CHPTMT/zero_day/hardware/cad/README.md

Put CAD source files here (one subfolder per assembly) and export STEP/STL files alongside them.
