CHPTMT/zero_day/hardware/electrical/README.md

Put wiring diagrams, schematics and the pin map here. Keep the pin map in step with firmware/include/arm_config.h.
