CHPTMT/zero_day/report/Group31_Robotic_Arm_Report.docx

MECN3066A Mechatronics II

Project Report: Recycled Robotic Arm

Group 31

Group members and student numbers: [to be completed by the group]

Demonstration: Monday 26 October 2026, NWE Laboratory

Submitted: [date]

# 1. Summary

This report describes a three degree of freedom robotic arm built mainly from recycled foam board and plywood, driven by four SG90 micro servos and controlled by an Arduino Uno. The arm works inside the 400 mm half circle set by the brief and completes four tasks without intervention: it checks Points A and B for an object with an ultrasonic sensor and answers with one of three gestures, reads the colour at Point C and lights a matching LED, measures the loudness of a tap at Point D and points at a matching height on a volume indicator, and presses a three letter word in Morse code on a push button at Point E, which a second Uno decodes and displays.

Joint angles are calculated on the board from the station coordinates with two link inverse kinematics that account for where each sensor sits on the sensor head. A finite element analysis of both links shows peak stresses below 0.1 MPa under twice the static load, so the links are not the limiting part. A torque check shows the opposite for the actuators: holding the arm at Point B needs 86% of the stall torque of the two shoulder servos, and the worst reachable pose needs 95%. The tension spring on the main arm and the gear mesh at the base are therefore the parts of the design that decide whether the arm works reliably.

# 2. Brief and requirements

The brief defines a working area of a 400 mm half circle, 400 mm high, with stations given in cylindrical coordinates (angle from the arm's left, radius from the base axis, height above the table). Table 1 lists them.

Table 1: Stations from the project brief

Station | Angle (deg) | Radius (mm) | Height (mm) | Task
A | 10 | 350 | 320 | Object present? (ultrasonic)
B | 10 | 350 | 150 | Object present? (ultrasonic)
C | 55 | 200 | 70 | Colour of the target, shown on an LED
D | 100 | 275 | 250 | Loudness of a tap
Volume indicator | 110 | 275 | 250 | Point at a height that matches the loudness
E | 170 | 250 | 300 | Press a word in Morse code on a push button

Other requirements from the brief and the demonstration notice:

- The button at Point E sits on a breadboard that the tutor mounts on the stand; its orientation is the group's choice.
- The Morse receiver runs on a second Uno, separate from the arm controller, and shows the word on an LCD.
- Each attempt at the demonstration is filmed, and the arm controller code, the receiver code and the videos are uploaded straight after the slot.
- The arm runs from reset with no help during an attempt. The best of the attempts in the 10 minute slot counts.

# 3. Mechanical design

## 3.1 Layout

The arm has a turntable base and two links in one vertical plane. The base servo turns a hub on a 20 mm plywood platform through a gear on the hub's rim. Two side plates on the hub carry the shoulder pivot 130 mm above the table, where two SG90 servos face each other and drive the main arm together in opposite directions, which doubles the shoulder torque. The second arm servo sits at the top of the main arm. A tension spring runs from the base to the main arm and carries part of the arm's weight. The sensor head at the end of the second arm holds the ultrasonic sensor on the arm axis, the sound sensor 42 mm further out and 45 mm to one side, the colour sensor 83 mm out and 45 mm to the other side, and a 70 mm button pusher hanging below the arm end.

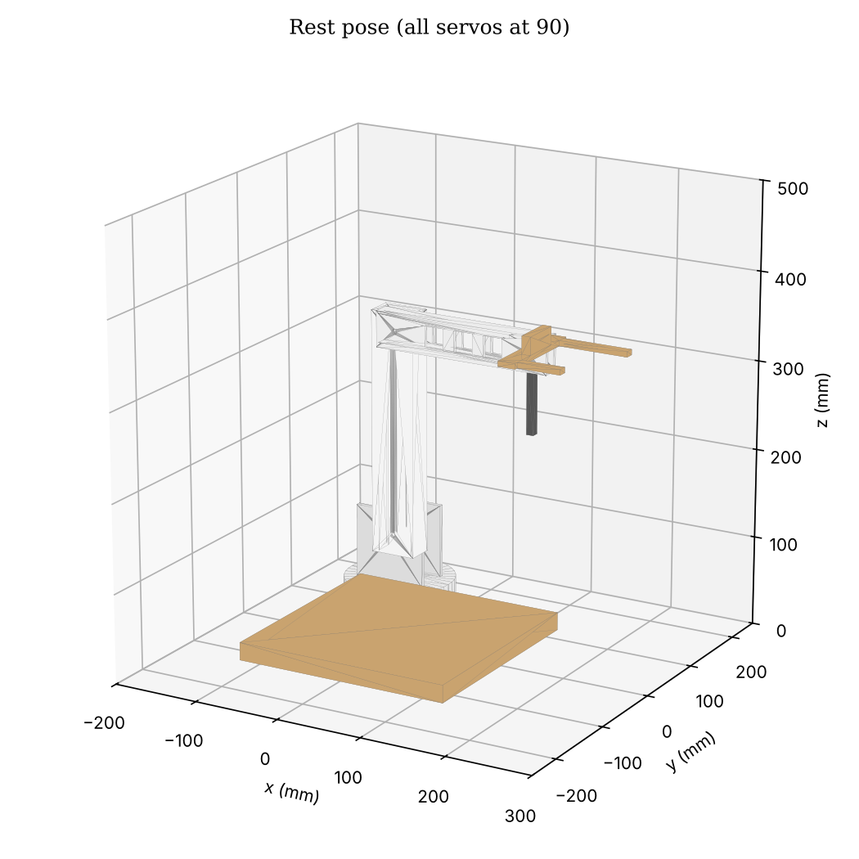
[picture p1: figure]

Figure 1: CAD model at the rest position: base facing forward, main arm upright, second arm level (all servos at 90 degrees)

Table 2: Main parts. Link masses come from the CAD volume and an assumed board density of 500 kg/m3

Part | Material | Size (mm) | Mass (g)
Base platform | Plywood | 250 x 250 x 20 | about 700
Turntable hub | Recycled tube, foam board | 120 diameter, 60 high | about 60
Main arm | 5 mm foam board box | 225 pivot to pivot, 50 x 30 section | 94
Second arm | 4 mm foam board box with three windows | 160 to the sensor head, 40 x 20 section | 36
Sensor head | Plywood, sensors, pusher, wiring | 110 wide | 46 (estimate)
Servos | SG90, 9 g, 1.8 kgf cm stall at 4.8 V | 23 x 12.2 x 22.7 | 4 x 9

## 3.2 Materials

The links are boxes made from white 5 mm foam board taped at the edges, with windows cut in the second arm to save weight. The platform and the sensor head are offcut plywood. The material properties used in the analysis are those of expanded PVC foam board (elastic modulus 800 MPa, Poisson's ratio 0.35, density 500 kg/m3, tensile strength 15 MPa), because the exact grade of the recycled board is not known. Section 6 shows that the stresses are so low that this uncertainty does not change any conclusion.

## 3.3 CAD files

The model is parametric (CadQuery, file hardware/cad/arm/build_cad.py) and uses the same dimensions as the controller code. It exports a STEP file for every part and two assemblies, one at the rest position and one at Point B. Figure 2 shows two of the working poses.

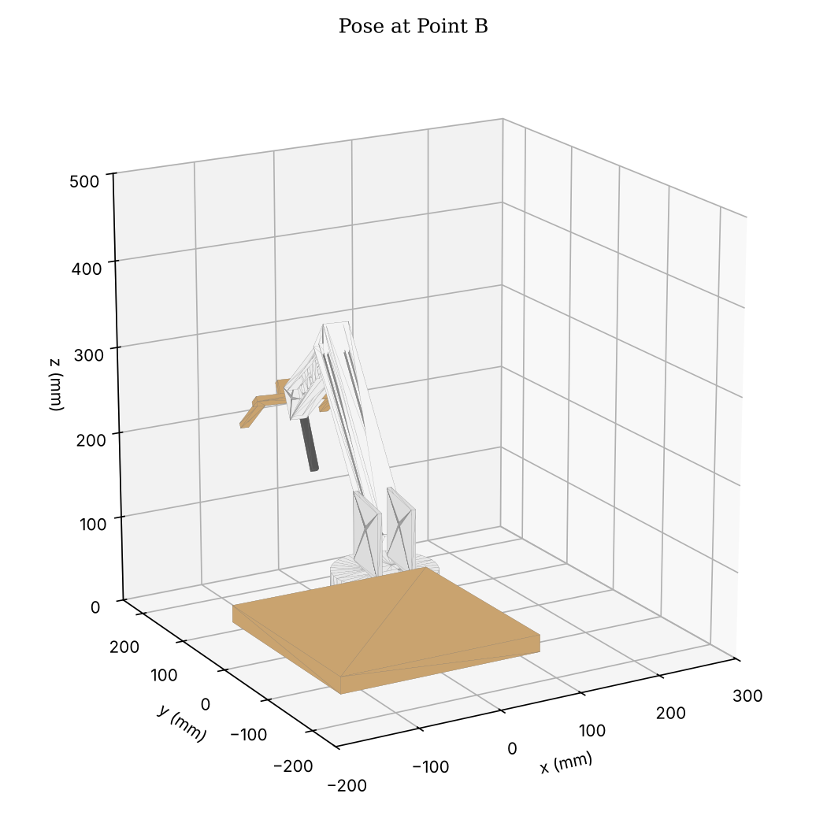
[picture p2: figure]

Figure 2: CAD model at Point B: base 80 degrees left, main arm 46.6 degrees forward, second arm 11 degrees up

# 4. Kinematics

All joint angles are relative to the rest position. The base angle is 90 degrees minus the station angle, corrected for the sideways offset of the sensor in use. In the arm's vertical plane the main arm is link 1 (225 mm, angle phi from vertical) and the second arm plus the sensor's offset along it is link 2 (160 mm plus the offset). For a target at in-plane distance r and height z, the sensor must sit a set standoff s back from the target along the direction it points. That point is solved with the law of cosines (elbow up), and because the pointing direction depends on the answer, the solution is repeated six times, which converges well within 0.1 mm.

For the button press the target is the pusher tip itself, with no standoff, so the arm can drive the tip along any line. Each press moves the tip straight down from 70 mm above the button to 20 mm into it, a 90 mm stroke. Pushing past contact means the servos keep pressing hard for the whole hold time. With two joints and a fixed button the joint angles at the press follow from the geometry, and a vertical press is mostly second arm motion. At the bottom of each press the main arm therefore leans a further 3 degrees, so the two main arm servos also push on the button.

Table 3: Joint angles calculated by the controller for each point (relative to the rest position)

Point | Sensor | Standoff (mm) | Base (deg) | Main arm (deg) | Second arm (deg)
A | Ultrasonic | 100 | 80.0 left | 23.7 forward | 20.4 up
B | Ultrasonic | 70 | 80.0 left | 46.6 forward | 11.0 up
C | Colour | 15 | 22.0 left | 33.3 forward | 40.6 down
D | Sound | 40 | 0.6 right | 13.0 forward | 11.2 down
Indicator, 150 mm | Ultrasonic | 60 | 20.0 right | 34.9 forward | 13.3 down
Indicator, 350 mm | Ultrasonic | 60 | 20.0 right | 14.2 forward | 14.6 up
E, above the button | Pusher tip | 36 above | 80.0 right | 17.2 forward | 43.8 up
E, pressing | Pusher tip | 12 in | 80.0 right | 19.4 forward | 31.5 up

Point C on the stands is a vertical blue face 70 mm above the table. With these link lengths and a shoulder 130 mm high the arm cannot bring the colour sensor down level with it: at C the second arm always points about 75 degrees down, so the sensor looks steeply down at the face from a few millimetres away. The code supports a colour sensor tilted up on a wedge (COLOUR_PITCH_DEG); with a 60 to 70 degree wedge the sensor looks at the face almost level while the arm pose hardly changes.

# 5. Actuator torque

The holding torque at each joint was calculated from the link masses in Table 2 with the second arm at its working angle. Table 4 compares it with the stall torque of the SG90 (1.8 kgf cm at 4.8 V, two servos at the shoulder).

Table 4: Static holding torque without the spring, against servo stall torque

Pose | Shoulder (kgf cm) | Share of 2 x SG90 | Elbow (kgf cm) | Share of 1 x SG90
A | 2.28 | 63% | 1.03 | 57%
B | 3.10 | 86% | 0.84 | 46%
C | 2.00 | 55% | 0.29 | 16%
D | 1.64 | 45% | 0.94 | 52%
E, above the button | 1.84 | 51% | 0.92 | 51%
Worst reachable: main arm 50 deg, second arm level | 3.41 | 95% | 1.03 | 57%

Micro servos lose accuracy and heat up well before stall, so the shoulder relies on the tension spring. Without it, Point B and any pose with the main arm leaning far forward would sag or stall. The elbow servo runs at half its stall torque just holding the head, which leaves little in reserve for pressing: a typical 6 mm tactile switch needs 1.6 to 2.5 N, and the elbow alone can add about 1 N at the 184 mm pusher lever. The straight-line press therefore uses the shoulder and elbow together, drives 20 mm past contact and leans the main arm 3 degrees extra at the bottom, so both joints push at close to full torque during the hold.

The base servo carries the turning load through a gear on the rim of the hub. When the arm leans out, the reaction lifts the hub on one side and the gear can ride out of the groove, after which every point is off by the angle lost. The controller now starts each servo gently (Section 7.3), but the lasting fix is mechanical: a washer or lip that keeps the gear in the groove, a stiffer servo mount, and if possible a thrust bearing under the hub so the base servo carries none of the arm's weight.

# 6. Structural analysis (FEA)

## 6.1 Method

Each link was meshed with 8-node hexahedral elements on a regular 2 to 2.5 mm grid that follows its real section: a hollow box with 5 mm walls for the main arm, and a 4 mm walled box with the three side windows for the second arm. Each link is clamped over the region gripped by the servo horn. Loads are the link's own weight, the weight of everything it carries and, for the second arm, the button-press reaction. A dynamic factor of 2 is applied to all weights to cover the accelerations of fast moves and the start-up jerk. The solver is written in Python (hardware/fea/fea_links.py) and solves the sparse stiffness system directly.

Before use, the solver was checked on a solid 20 x 20 x 200 mm cantilever with a 1 N tip load. The tip deflection was 0.2467 mm against 0.2520 mm from beam theory with shear (-2.1%). A pure end moment on the main arm section and a tip load on the same section each gave bending stresses within 6% of M c / I at mid span, which also confirmed the sign of the elbow moment.

## 6.2 Load cases and results

Table 5: FEA results (peak stress outside the clamp and load patches)

Case | Elements | Peak von Mises (MPa) | Safety factor on 15 MPa | Tip deflection (mm)
Second arm level, weights x2 (head 46 g at the tip) | 9072 | 0.082 | 184.0 | 0.05
Second arm pressing, weight x1 with a 0.96 N press reaction | 9072 | 0.023 | 659.0 | 0.016
Main arm at 50 deg, elbow force 1.791 N and moment 201.4 N mm, weights x2 | 12096 | 0.075 | 198.9 | 0.088

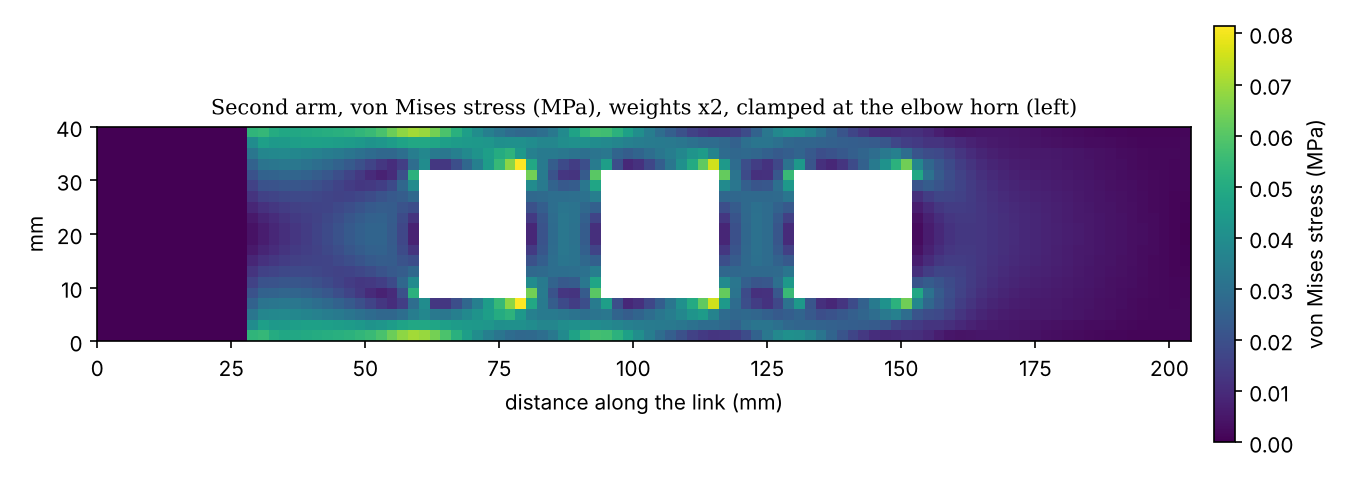
[picture p3: figure]

Figure 3: Second arm: von Mises stress with all weights doubled. The highest stresses sit at the corners of the windows

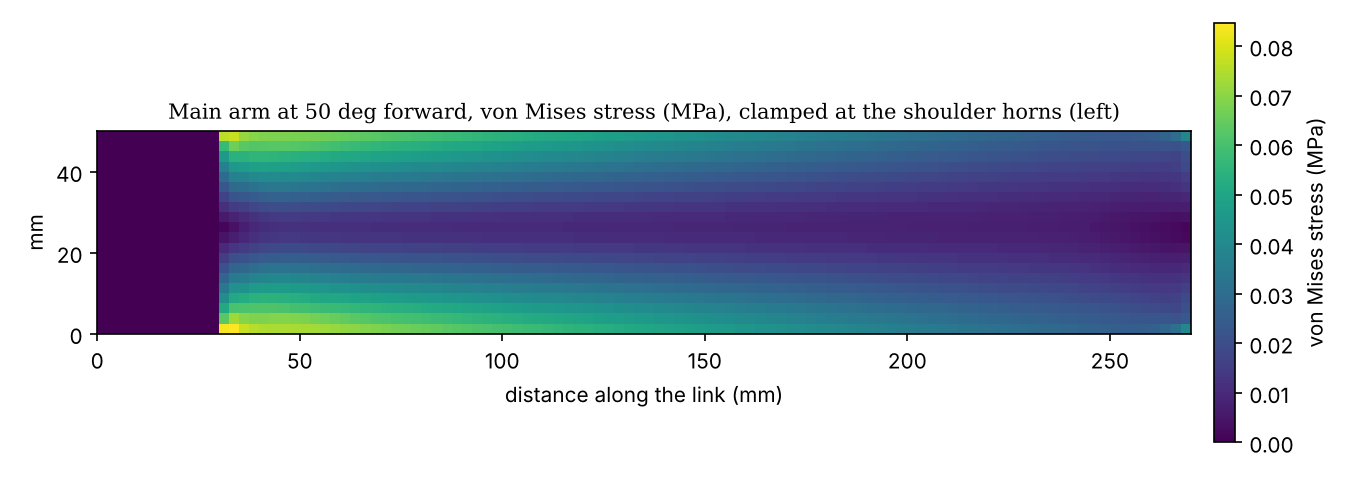
[picture p4: figure]

Figure 4: Main arm at its 50 degree limit: von Mises stress, highest in the outer walls next to the shoulder horn

## 6.3 Discussion

Peak stresses are below 0.1 MPa, at least 150 times below the strength of the board, and tip deflections are below 0.1 mm. Hand calculation agrees: the main arm moment at the shoulder in the worst pose is about 670 N mm, giving 0.08 MPa in the outer wall against 0.075 MPa from the FEA. The window corners in the second arm raise the local stress by about 50% over the plain section, which is still negligible. The links could be made lighter, and the useful saving is mass rather than strength, since every gram at the head costs elbow and shoulder torque (Section 5). The FEA does not cover the taped joints, the servo horn screws or the gear mesh, which are the parts most likely to fail in practice.

# 7. Electronics and software

## 7.1 Electronics

Table 6: Arm controller pin map

Device | Pin | Notes
Base servo | D2 | SG90
Main arm servos, left and right | D3, D4 | Driven in opposite directions
Second arm servo | D5 | SG90
Ultrasonic HC-SR04 | Echo D6, Trig D7 | 5 V
Sound sensor | A1 | Analogue output
Colour sensor TCS34725 | SDA A4, SCL A5 | Hardware I2C
Red, green, blue LEDs | D8, D9, D10 | 220 ohm each, active high
Beeper | D11 | Passive, 2.5 kHz tone
LCD monitor 16 x 2, I2C backpack | SDA A2, SCL A3 | Software I2C, address 0x27 or 0x3F
Servo supply | External 5 V, 2 A | Common ground with the Uno
Morse receiver (second Uno) | Button D7, LCD on A4/A5 | Separate board

The servos run from an external 5 V supply because four SG90s can draw more than an amp together when they start or stall, far more than the Uno's regulator can give. The LCD monitor uses A2 and A3 because the colour sensor already occupies the hardware I2C pins; a small software I2C driver in the sketch talks to it, so no library is needed.

## 7.2 Program structure

The arm controller is a state machine: rest hold, Task 1, Task 2, Task 3, Task 4, finish, idle. During the 5 s rest hold the Morse word can be typed in the Serial Monitor; it is saved in EEPROM. Each task beeps its number at the start and at the end and then waits 2 s. Every move uses cosine easing with a top joint speed of 30 degrees per second, which keeps the motion smooth and avoids jerks. The Serial Monitor prints every move in plain words, and the LCD shows the task, the distances at A and B, each result and a summary at the end.

- Task 1: the arm goes to A and measures the distance (median of five pings, at least three echoes). If nothing is straight ahead it looks a little left, right, up and down. An object counts between 2 and 25 cm. It then lifts and turns away so the visit to B is clearly separate. Object at A: YES (the sensor moves straight up and down). Object at B: NO (the base turns left and right). Nothing at either: BOX (the sensor traces a square).
- Task 2: at C the colour sensor waves over five spots, the LEDs follow what it sees, and the clearest reading decides the colour. The matching LED stays lit to the end of the run.
- Task 3: at D the arm waits up to 3 s for a tap and measures its peak to peak amplitude. It then moves to the bottom of the indicator scale and rises slowly to a height from 150 mm (quiet) to 350 mm (loud), drops back and rises again like a level meter, and holds.
- Task 4: at E each press drives the pusher straight down and up at 120 degrees per second. Dots are 600 ms and dashes 1800 ms, with 600 ms between presses and 1800 ms between letters.

## 7.3 Start-up and calibration

A hobby servo cannot report its position, so the first pulse after power-up sends it to the commanded angle at full speed. On this arm that jerk pulled cables loose and lifted the base gear out of its groove. The controller now sends each servo short bursts of pulses with pauses between them, so it creeps to the rest position: second arm first, then the main arm pair together, then the base, slowest of all. The base then sweeps slowly to both ends and back to the middle with the head lifted, which beds the gear in and shows the swing is clear. Throughout the run the base is limited to 18 degrees per second, below the 30 degrees per second of the other joints. Two calibration sketches support the set-up. test_servos lets each joint be nudged to the true rest position (the two main arm servos can be trimmed separately so they do not fight) and prints the zero values to paste into the code. capture_points takes the arm to every station as the demonstration does, lets each one be nudged onto the real stand, tunes the press depth and height at E, and prints the corrected station lines.

## 7.4 Morse timing

The receiver splits dots from dashes at 1250 ms and ends a letter after 1200 ms of silence. A release shorter than 100 ms is treated as contact bounce within the same press. The press timing was checked in an offline model of the arm that runs the real sketch, tracks the pusher tip from the servo commands and records when the button would close. With the button from 50 mm higher to 32 mm lower than its nominal position, the button saw dots of 400 to 800 ms, dashes of 1600 to 2000 ms, gaps of 390 to 790 ms inside a letter and 1590 to 1990 ms between letters, so every band is at least 350 ms from a threshold. Both receiver sketches were then run against these recorded contact timelines: 1,536 runs covering eight words, eight button heights and contact chatter up to 90 ms, and 840 runs with every edge shifted randomly by up to 150 ms, all decoded correctly.

# 8. Testing and results

## 8.1 Tests before the demonstration

- Every sketch is compiled for the Uno on each change by an automated build (GitHub Actions).
- A browser simulator runs the same joint maths and task sequence and draws the arm to scale (simulation/arm_bench.html). It was used to check reach, joint limits and the order of moves.
- An offline model compiles the real sketch on a PC with simulated sensors, servos, LCD and button, and checks the beep pattern, gestures, joint limits, LCD text and Morse decoding for different conditions.
- On the real arm, test_servos, test_sensors and test_combined were used to set the zero positions, directions, colour references and sound levels, and to visit every station.

## 8.2 Problems found and fixes

Table 7: Problems found during testing

Problem on the real arm | Cause | Fix
Main arm leaned back when it should lean forward | Servo direction | MAIN_DIR set to -1
Points off after start-up | Zero positions not set, base gear jumping teeth | Zero calibration in test_servos; soft start; gear retention
Base gear lifts out of the turntable groove | Start-up jerk and the arm's moment on the hub | Soft start, base held to 18 deg/s, slow start-up sweep; mechanical retention recommended
Button presses too weak | Elbow servo near half its stall torque just holding the head | Straight-line press with both joints, 20 mm past contact, 3 degree extra main arm lean, 120 deg/s
Visit to B not visible | A and B share one bearing | Lift and turn away between A and B
Point C is a vertical face | Arm cannot reach low enough to look level | Sensor waves over five spots; optional tilted sensor mount
Button on a sloping stand | Stand design | Breadboard mounted so the button faces up; straight-down press

## 8.3 Demonstration results

[To be completed after the demonstration: for each attempt, the conditions set by the tutors (object at A, B or neither; colour; tap; word), what the arm did at each point, and whether each task passed. Link the videos.]

Table 8: Demonstration results (to be filled in)

Attempt | Task 1 (A/B, gesture) | Task 2 (colour) | Task 3 (sound) | Task 4 (Morse)
1
2
3

# 9. Recommendations

- Hold the base gear in mesh with a lip or washer and carry the arm's weight on a thrust bearing, so the base servo only turns the hub.
- Replace the shoulder SG90 pair with metal gear servos such as the MG90S (2.2 kgf cm) or a single MG996R, or keep the spring and check its preload so the shoulder runs well below stall at Point B.
- Lighten the sensor head: every 10 g there costs about 0.16 kgf cm at the elbow.
- Mount the colour sensor on a 60 to 70 degree wedge so it faces the vertical target at C squarely.
- Use a low-force button (below 1.5 N) at Point E, or add a short spring-loaded tip to the pusher so presses are consistent.

# 10. Conclusion

The arm reaches every station in the brief with the right sensor at a set distance, using joint angles calculated on the board. The foam board links are far stronger than they need to be, while the servos, the spring and the base gear set the limits of the design. The changes made during testing (soft start, calibrated zero positions, a firm straight-line press, a wider search at A and B, a colour scan at C and a clear level-meter motion at D) target the failures seen on the real arm.

# References

1. MECN3066A Mechatronics II Project Brief 2026, University of the Witwatersrand.
2. TowerPro SG90 micro servo datasheet.
3. ams AG, TCS3472 colour light-to-digital converter datasheet.
4. Elecfreaks, HC-SR04 ultrasonic ranging module user guide.
5. Hitachi, HD44780U dot matrix LCD controller datasheet; NXP, PCF8574 remote 8-bit I/O expander datasheet.
6. Arduino, Servo library reference, https://www.arduino.cc/reference/en/libraries/servo/.
7. R. C. Hibbeler, Mechanics of Materials, Pearson.

# Appendix A: Files

Table 9: Files submitted with this report

File | Contents
arduino/arm_controller/arm_controller.ino | Demonstration program
arduino/morse_receiver, morse_receiver_i2c | Receiver on the second Uno
arduino/tests/test_servos | Zero positions, directions, sweep, manual control
arduino/tests/test_sensors | Sensor readings and calibration
arduino/tests/test_combined | Every station and movement without decisions
arduino/tests/capture_points | Station trims and press tuning on the real stands
hardware/cad/arm/*.step | CAD parts and assemblies
hardware/fea/fea_links.py, fea_results.json | FEA solver, load cases and results
simulation/arm_bench.html | Browser simulator
docs/demo_day.md, docs/wiring.md | Demonstration procedure and wiring
