CHPTMT/zero_day/arduino/morse_receiver_i2c/src/README.txt

Bundled library, so the sketch compiles without installing anything:
- LiquidCrystal_I2C 1.1.4 (github.com/johnrickman/LiquidCrystal_I2C, the Frank de Brabander library), unchanged.
