CHPTMT/zero_day/report/cad_point_E.png

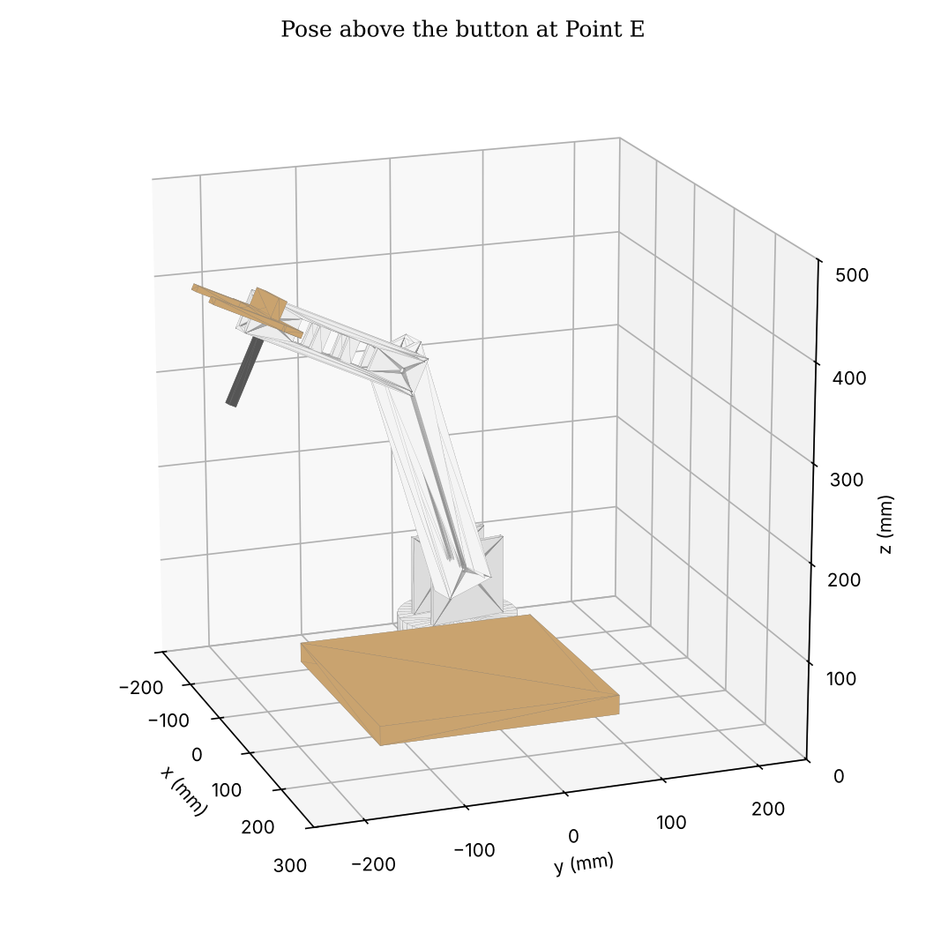
report/cad_point_E.png
