CHPTMT/zero_day/hardware/cad/arm/assembly_rest_pose.step

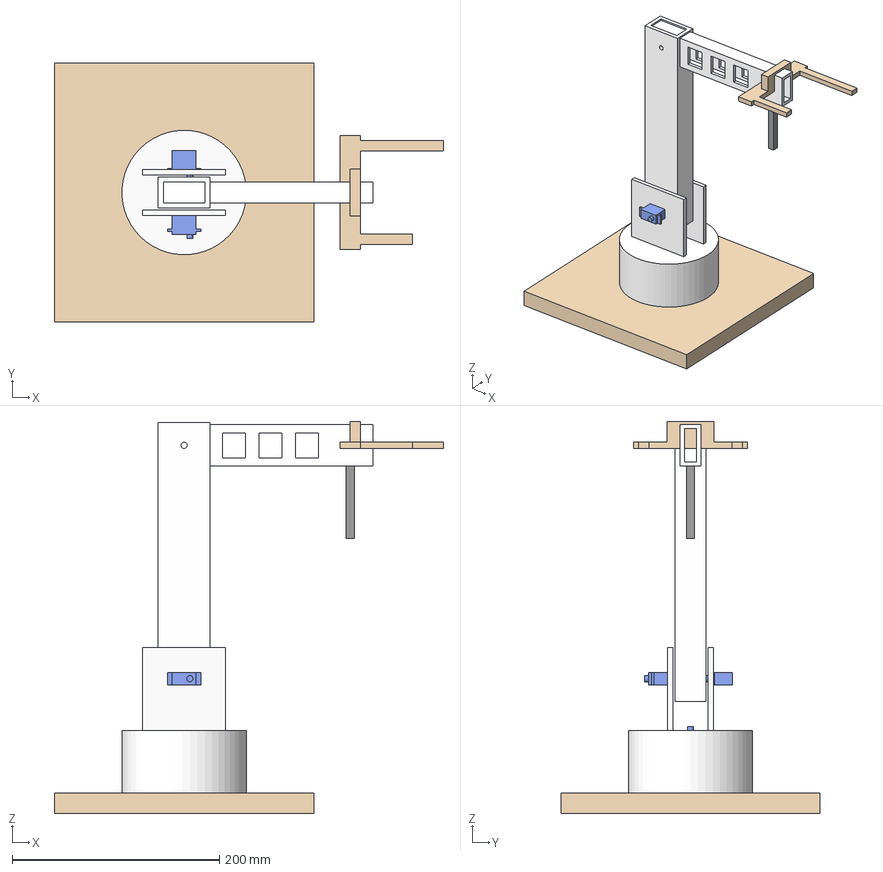
[picture p6: CAD file, 2026-10-26]
hardware/cad/arm/assembly_rest_pose.step
375.0 x 250.0 x 378.0 mm
base_plate
hub
bracket
servo_base
servo_main_left
servo_main_right
main_arm
second_arm
sensor_head
pusher
