CHPTMT/zero_day/hardware/cad/arm/assembly_point_B.step

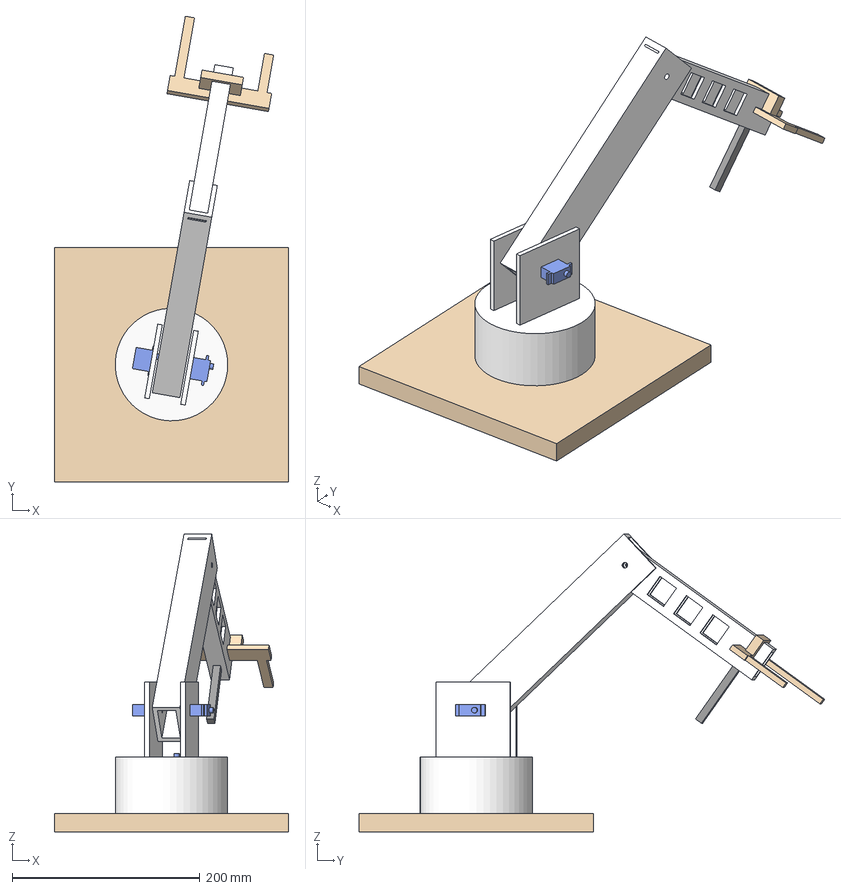
[picture p7: CAD file, 2026-10-26]
hardware/cad/arm/assembly_point_B.step
250.0 x 496.6 x 317.9 mm
base_plate
hub
bracket
servo_base
servo_main_left
servo_main_right
main_arm
second_arm
sensor_head
pusher
