CHPTMT/zero_day/hardware/cad/arm/main_arm.step

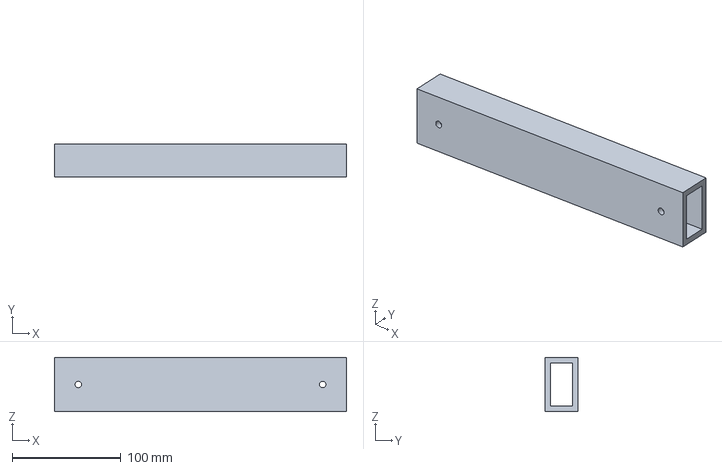
[picture p8: CAD file, 2026-10-26]
hardware/cad/arm/main_arm.step
269.0 x 30.0 x 50.0 mm
