CHPTMT/zero_day/hardware/cad/arm/hub.step

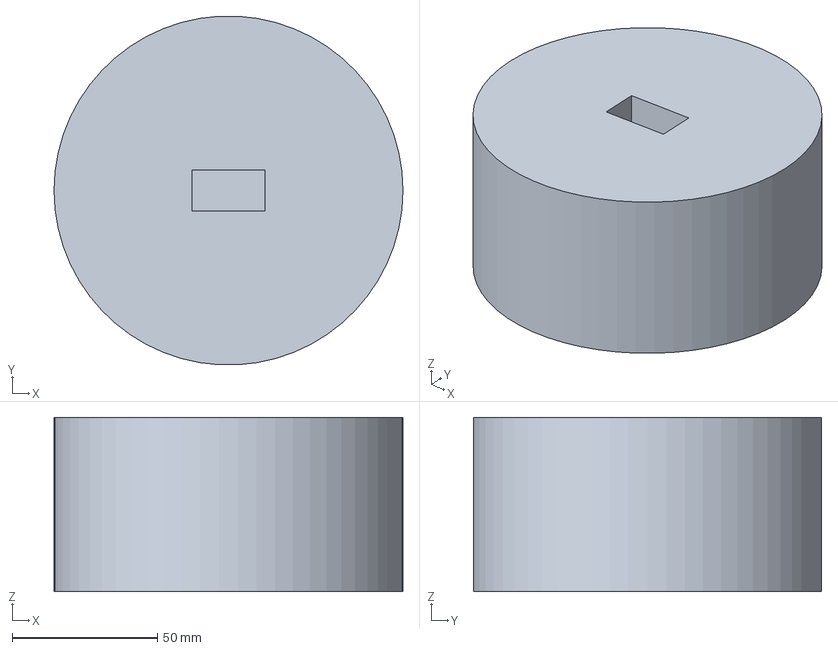
[picture p9: CAD file, 2026-10-26]
hardware/cad/arm/hub.step
120.0 x 119.8 x 60.0 mm
