CHPTMT/zero_day/hardware/cad/arm/base_plate.step

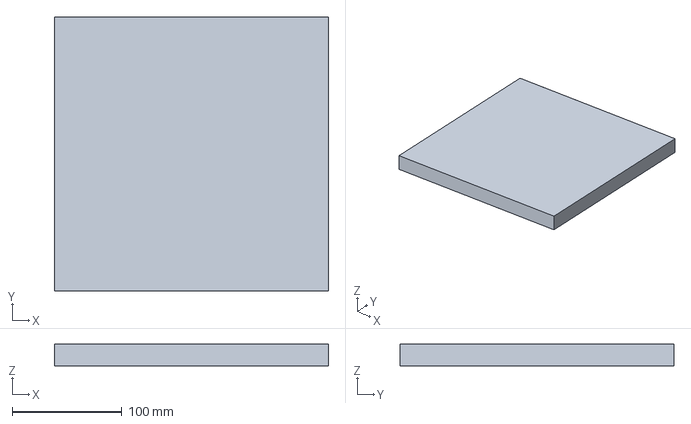
[picture p10: CAD file, 2026-10-26]
hardware/cad/arm/base_plate.step
250.0 x 250.0 x 20.0 mm
