CHPTMT/zero_day/hardware/cad/arm/pusher.step

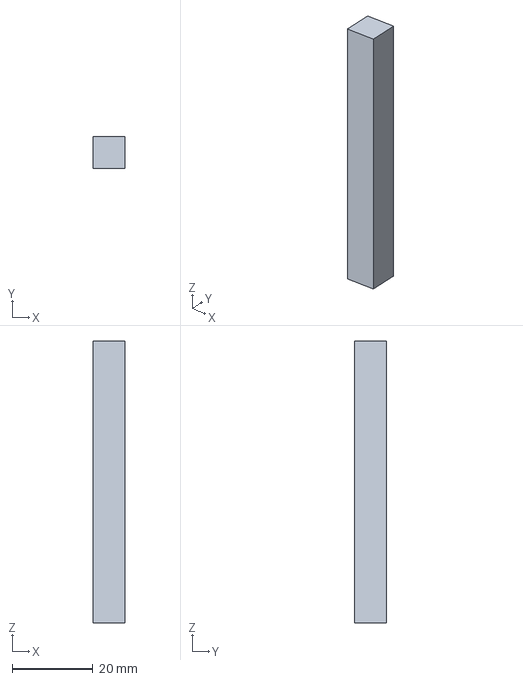
[picture p11: CAD file, 2026-10-26]
hardware/cad/arm/pusher.step
8.00 x 8.00 x 70.0 mm
