CHPTMT/zero_day/hardware/cad/arm/bracket.step

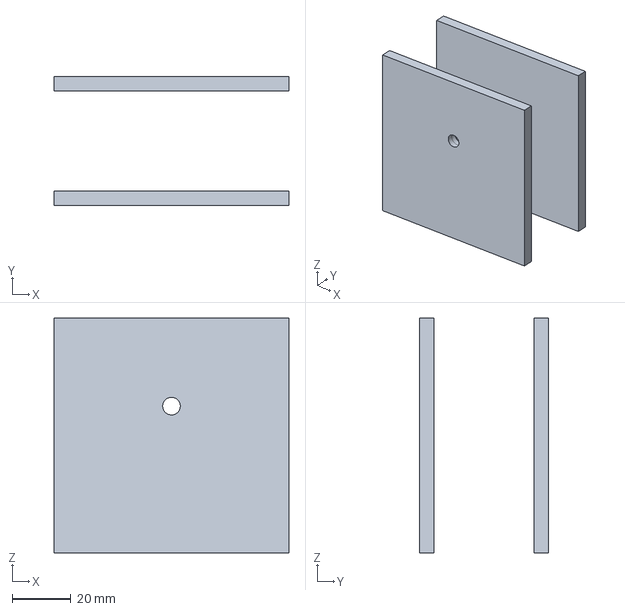
[picture p12: CAD file, 2026-10-26]
hardware/cad/arm/bracket.step
80.0 x 44.0 x 80.0 mm
