CHPTMT/zero_day/hardware/cad/arm/servo_sg90.step

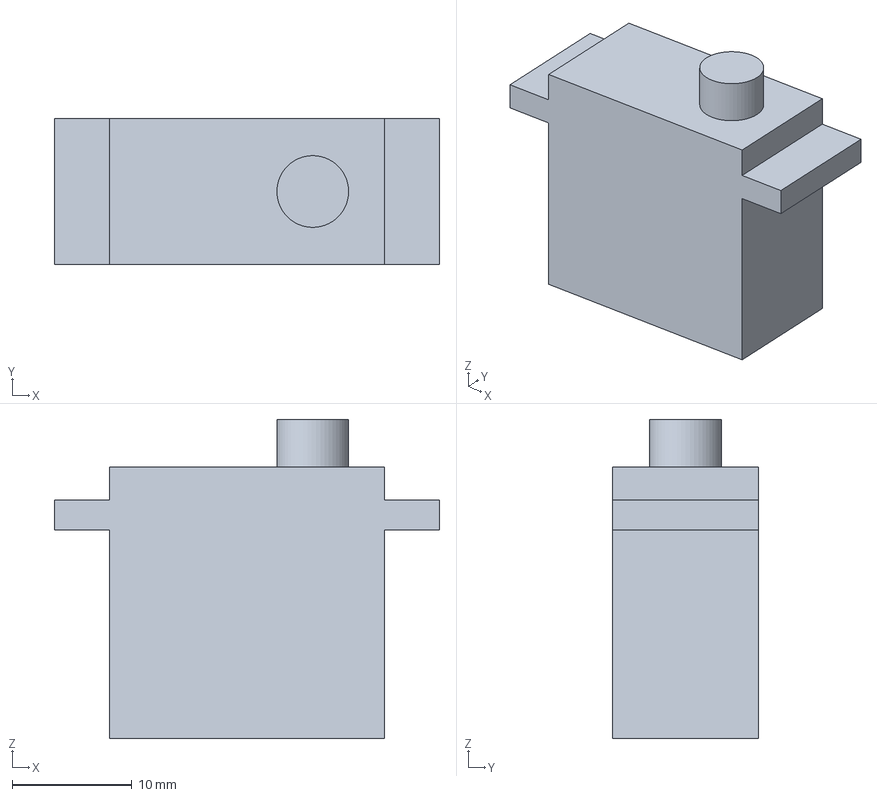
[picture p13: CAD file, 2026-10-26]
hardware/cad/arm/servo_sg90.step
32.2 x 12.2 x 26.7 mm
