CHPTMT/zero_day/hardware/cad/arm/sensor_head.step

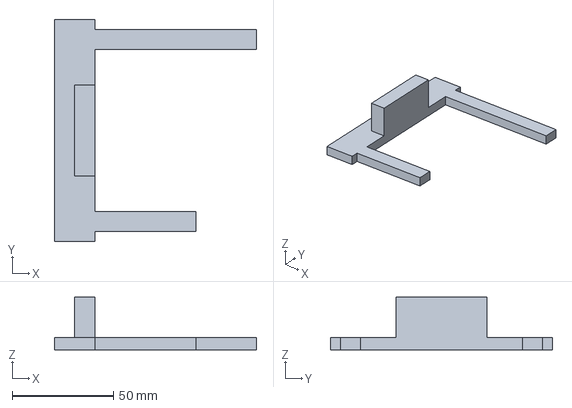
[picture p14: CAD file, 2026-10-26]
hardware/cad/arm/sensor_head.step
100.0 x 110.0 x 26.0 mm
