CHPTMT/zero_day/hardware/cad/arm/second_arm.step

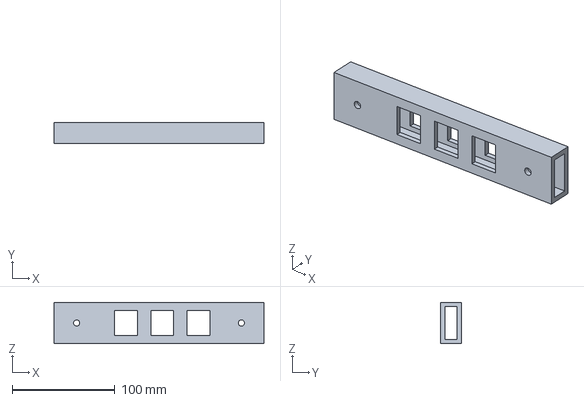
[picture p15: CAD file, 2026-10-26]
hardware/cad/arm/second_arm.step
204.0 x 20.0 x 40.0 mm
