CHPTMT/zero_day/report/sim_wiring.png

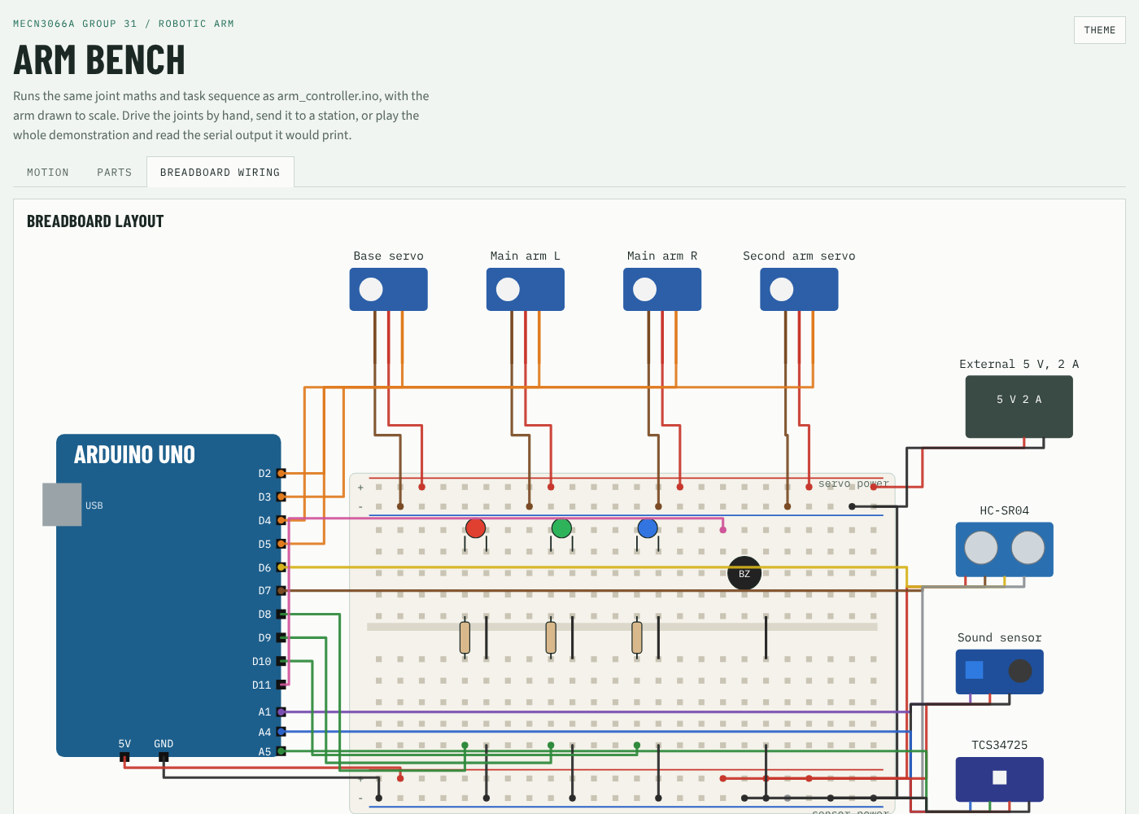
report/sim_wiring.png
