CHPTMT/zero_day/(commit log)

2026-10-24 Set up robotic arm project structure
    Add config-driven Python host package (DH kinematics, damped least
    squares IK, synchronised trapezoidal trajectories, serial protocol),
    PlatformIO firmware for Mega/ESP32 with limit checks and e-stop,
    hardware and docs templates, and CI for tests and firmware builds.
    All arm parameters are placeholders until real specs are supplied.
    Claude-Session: https://claude.ai/code/session_015nyq1RBSgqgf9GgU1FWB3V
    [bom.csv]
2026-10-24 Replace placeholder scaffold with Arduino demo and test sketches
    Main controller runs Tasks 1 to 4 as a state machine with timeouts and
    safe defaults on every sensor. Separate receiver decodes the Point E
    Morse presses onto an LCD. Seven test sketches cover servos and pose
    teaching, ultrasonic, colour calibration, sound, LEDs, Morse pressing
    and the receiver button. CI compiles every sketch for the Uno.
    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
    [bom.csv]
2026-10-24 Rename receiver buffer: word is a reserved Arduino type
    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
2026-10-24 Match code to the built arm: pins, mirrored main arm, relative angles
    Pins from the wiring list (base D2, main arm D3/D4 mirrored, second arm
    D5, ultrasonic D6/D7, sound A1). Joint angles are relative with the
    requested limits, and station poses come from on-board inverse
    kinematics using the measured link lengths. Every run starts with a
    5 s zero hold and reports position and sensor readings over Serial.
    Tests reduced to servos, sensors and combined movements.
    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
2026-10-24 Add colour temperature readout, arm bench page and Wokwi project
    Colour readings now print colour temperature, lux and the strongest
    channel. simulation/arm_bench.html animates each sketch on a scaled
    model of the arm with its serial output and shows the breadboard
    wiring. simulation/wokwi holds a diagram for running the real sketch
    in the Wokwi simulator.
    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
2026-10-24 Add 50 mm button pusher bar for Point E
    The pusher is fixed square to the second arm (down at 0) at
    PUSHER_MOUNT_MM. Point E now aims the pusher tip along the bar, hover
    15 mm and press 8 mm past contact. Position printouts include the
    pusher tip, and the arm bench page draws the bar and the E button.
    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
    [arm_controller.ino, test_combined.ino]
2026-10-24 Aim each sensor from its real place on the sensor board
    Ultrasonic at the board centre (end of the second arm), colour sensor
    83 mm down and 45 mm right, sound sensor 42 mm down and 45 mm left,
    pusher 20 mm out and 50 mm down. One tool-based IK aims the right part
    at each station, including the sideways offset, with standoffs set to
    each sensor's working range. Arm bench page draws the board and lists
    the sensor ranges.
    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
2026-10-24 Fix base direction: A and B are on the arm's left, E on its right
    Base + now turns towards A and B to match the test station base map,
    and the plan view is drawn from behind the arm the same way. Sensor
    side offsets keep their meaning (colour sensor on the arm's left).
    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
    [arm_controller.ino, test_combined.ino, test_servos.ino]
2026-10-25 Sensor array along the second arm axis, pusher below it at the arm end
    Sound sensor 42 mm and colour sensor 83 mm out along the arm (45 mm
    left and right), ultrasonic at the arm end, 50 mm pusher hanging below
    the array at the arm end. If pressing E needs the second arm past +45
    (pivot height 60 mm), the arm holds +45 and sets the main arm so the
    pusher tip is at the right height, landing about 5 mm short, instead
    of clamping into an early press.
    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
    [arm_controller.ino, test_combined.ino]
2026-10-25 Use measured pivot height: 130 mm above the table
    20 mm platform plus 110 mm to the main arm pivot. Every station,
    including the Point E press, now sits inside the joint limits.
    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
2026-10-25 Add top view and parts drawings; true arm widths; pusher tip 70 mm down
    Side view draws the main arm 50 mm and the second arm 40 mm wide at
    their side faces. New top view of the arm from the front, and a Parts
    tab drawing each piece with its dimensions. The 50 mm pusher hangs
    from the underside of the 40 mm arm, so its tip is 70 mm below the
    arm's centre line in both sketches and the page.
    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
2026-10-25 Use a 30 mm pusher bar and draw the base hub
    30 mm bar (tip 50 mm below the second arm's centre line) presses
    Point E within 2 degrees of straight down with the second arm near
    +25. The page draws the base hub, its turning ring and the arched
    main arm bracket in the side, top, parts and assembly views.
    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
2026-10-25 Arm bench: side, top and plan views side by side with a live values strip
    Page widened to 1840 px. The three views and a strip of every changing
    value (state, target, joint angles, raw servo values, each sensor's
    position, latest distance, colour, sound and Morse readings, LEDs and
    button) stay pinned at the top on wide screens while the controls and
    serial monitor scroll underneath. View notes and the sensor table move
    into a collapsible section.
    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
2026-10-25 Smoother, slower motion: fine pulse steps and a 30 deg/s speed cap
    Servos are driven with writeMicroseconds (about 0.1 degree steps)
    instead of whole-degree write(), updates run once per 20 ms servo
    frame, and every move is stretched so no joint exceeds 30 deg/s.
    test_servos sweeps at 25 deg/s in half-degree steps. The arm bench
    page uses the same speed cap.
    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
2026-10-25 Plain-English Serial Monitor output in every arm sketch and the page
    Messages now say what the arm is doing in words: where it arrived,
    each joint described as turned/leaning/tilted and by how much, where
    each sensor is, what each sensor found, which gesture and why, the
    Morse letters as short and long presses, and a readable run summary.
    Warnings say what went wrong and what the arm does instead. The arm
    bench page prints the same text.
    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
    [arm_controller.ino, test_combined.ino, test_sensors.ino, test_servos.ino]
2026-10-25 Open every sketch on Arduino UNO, arm sketches on COM8
    Adds sketch.yaml (default_fqbn arduino:avr:uno, default_port COM8) to
    the arm controller and the three test sketches, and the board only to
    the Morse receiver, which runs on a second Uno with its own port.
    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
2026-10-25 Bundle the colour sensor and LCD libraries inside the sketches
    Each sketch that needs them carries Adafruit_TCS34725 (with the
    Adafruit_I2CDevice helper from BusIO) or LiquidCrystal_I2C in its own
    src folder, with licences, so it compiles on a laptop with nothing
    installed. CI no longer installs those libraries, so it now proves the
    bundled copies are enough.
    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
    [arm_controller.ino, morse_receiver.ino, test_combined.ino, test_sensors.ino]
2026-10-25 Morse two times slower with eased presses; add the team's receiver
    The arm now presses with a 600 ms unit (dot 600, dash 1800) and eases
    onto and off the button over 300 ms instead of snapping, with the hold
    and pauses shortened so the receiver still sees the intended lengths.
    Both receivers split dots, dashes and letters at 1200 ms. The team's
    receiver is added as morse_receiver_i2c with DOT_MAX 1200, LETTER_GAP
    1200, WORD_TIMEOUT 6000 and its LCD library bundled. Simulated eased
    presses decode all 10 brief words on both receivers.
    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
    [arm_controller.ino, morse_receiver.ino, morse_receiver_i2c.ino, test_combined.ino]
2026-10-25 Bigger gestures (10 degrees), point-by-point checklist, home test layout
    Gestures swing 10 degrees each way (6 was too small to see) at the same
    slow 900 ms. demo_day.md now lists every point's joint angles and what
    it should look like, explains that a reversed joint direction makes the
    arm rise at Point C instead of dipping, and gives the table layout for
    testing at home without the stands.
    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
    [arm_controller.ino, test_combined.ino]
2026-10-25 Add test_one_servo: move a single servo on its own to check wiring and power
    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
2026-10-25 Common anode RGB LED on D8, D9, D10 follows the colour sensor
    The LED's long leg goes to 5 V, so a LOW pin lights that colour.
    At Point C the LED follows the sensor live for 2 s, then holds the
    final colour. test_sensors uses the same active LOW logic. Wiring
    doc and the bench page show the RGB LED wired to the 5 V rail.
    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
2026-10-25 Press and gesture with the main arm and base, hold at each point
    Each Morse press is now the main arm leaning about 9 degrees forward
    from 30 mm above the button, with the base and second arm still; the
    gaps between presses allow for the longer move. YES nods the main arm,
    NO shakes the base and BOX uses both, 15 degrees each way, centred so
    the swing stays inside the joint limits. The arm holds 2 s at every
    point and lifts clear between A and B. Start up shows red, green and
    blue alone for 1 s each, and the live LED at C only changes after
    three matching readings so it shows one solid colour.
    Claude-Session: https://claude.ai/code/ses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
2026-10-25 Separate LEDs, task beeper, distinct gestures, visible presses
    Three LEDs on D8, D9, D10 (red, green, blue), each lit by a HIGH pin.
    A beeper on D11 beeps N times at the start and end of Task N, then
    the arm waits 2 s. YES now moves the sensor straight up and down, NO
    turns the base, BOX traces a square with both, each with a short
    stop at the ends. Presses at E drop the pusher 48 mm straight down
    from 40 mm above the button. A and B each get a 3 to 15 cm detection
    window and need 3 of 5 echoes. Docs and the bench page match.
    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
    [arm_controller.ino, test_combined.ino, test_sensors.ino]
2026-10-25 arm_controller: fix comment typo
    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
    [arm_controller.ino]
2026-10-25 Second arm presses at E, separate visit to B, receiver timing
    Each Morse press is now the second arm tilting 18 degrees down onto
    the button and back up at 60 deg/s, with holds and gaps timed for the
    button closing near the bottom of the stroke. Between A and B the arm
    lifts and turns 25 degrees towards the front, then comes back down to
    B with the sensor 7 cm away. Both receivers split dot from dash at
    1100 ms and end a letter after 1300 ms, halfway between the press and
    gap times the pusher actually produces.
    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
2026-10-25 arm_controller: update detection window comment for B at 7 cm
    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
2026-10-25 Keep the colour sensor clear of A, B, D and the indicator
    The colour sensor sits 83 mm past the ultrasonic, so a 70 mm stop at B
    put its tip past the point. A, B and the indicator now stop 120 mm
    away and D 80 mm, leaving the colour sensor tip at least 37 mm short.
    The A and B detection window moves to 3 to 17 cm to match.
    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
    [arm_controller.ino, test_combined.ino, test_sensors.ino]
2026-10-25 Servo rest positions set on the arm, slower base for its gear
    Every servo now centres on 1500 us with a 500 to 2500 us range, and
    each one has its own rest pulse. Typing ZERO during the rest hold
    opens a set-up where each servo is nudged and the result saved in
    EEPROM; test_servos and test_combined read the same values. The base
    turns at 15 deg/s at most so its gear stays in the turntable groove,
    and BASE_GEAR_RATIO covers a geared turntable.
    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
2026-10-25 Keep servo directions with the rest positions in EEPROM
    Joint directions were constants in the code, so pasting a new version
    put back any direction a team member had flipped. SETUP (typed during
    the rest hold) now tests each joint (tb, tm, te), flips it (fb, fm,
    fe) and nudges each rest pulse, and SAVE keeps both in EEPROM.
    test_servos and test_combined read the same values.
    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
    [arm_controller.ino, test_combined.ino, test_servos.ino]
2026-10-25 test_combined: define servo helpers after the types they use
    The Arduino IDE puts its generated prototypes before the first function,
    so loadZeros and pulseAt above struct Pose broke the build.
    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
    [test_combined.ino]
2026-10-25 Go back to the earlier servo mapping that worked better on the arm
    Restores the 90 degree zeros, the 544 to 2400 us scale and the default
    attach in arm_controller, test_servos and test_combined, and removes the
    SETUP command, EEPROM rest positions and the slower base limit. All task
    behaviour (stations, gestures, presses, beeper, LEDs) is unchanged.
    Docs: base gear fix as its own step, home-test table row for D.
    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
    [arm_controller.ino, test_combined.ino, test_servos.ino]
2026-10-25 Use the arm_controller version that works on the arm, add capture_points
    arm_controller, test_combined and test_sensors go back to the version the
    team confirmed works (A 100 mm, B 70 mm, D 40 mm, indicator 60 mm, window
    3 to 15 cm). arm_controller gains IND_TRIM for the indicator, zero by default.
    New tests/capture_points visits every point as the demo does, lets the arm
    be nudged onto the real stand and prints the Station lines and IND_TRIM
    with trims to paste back. Simulator and docs use the same values.
    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
2026-10-25 Point C vertical face, 70 mm pusher, presses along the sloping button's axis
    C on the real stand is a vertical blue face 70 mm up. The arm cannot look
    at it level, so the colour sensor gets a pitch (COLOUR_PITCH_DEG, 0 until
    a wedge is fitted) that the aiming maths uses. The pusher is now 70 mm
    (tip 90 mm below the arm). The E breadboard sits on a sloping stand, so
    each press now moves the tip in a straight line along the button's axis
    (E_STAND_ANGLE_DEG, BUTTON_TILT_DEG, both 45 from the photo) instead of
    tilting only the second arm. Same changes in test_combined, capture_points,
    the simulator and the docs.
    Claude-Session: https://cla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
2026-10-25 capture_points: declare the capture types before the first function
    The Arduino IDE puts its generated prototypes above the first function,
    so trimOf() and captureStop() referred to Stop before it existed.
    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
2026-10-25 LCD monitor on A2/A3: task, A and B distances, results, end summary
    A 16x2 I2C LCD on A2 (SDA) and A3 (SCL) shows which task is running, the
    distances read at A and B, each task's result, the Morse letters as they
    are sent, and two summary screens at the end. A2/A3 are not hardware I2C,
    so a small software I2C driver is built in (address 0x27 or 0x3F found at
    start up; the run carries on without an LCD). Also gives every Tool its
    pitch explicitly to silence the missing-initialiser warnings.
    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
    [arm_controller.ino, capture_points.ino, test_combined.ino]
2026-10-25 Point E: press straight down with the 70 mm pusher
    Removes the sloping-button axis (E_STAND_ANGLE_DEG, BUTTON_TILT_DEG). Each
    press now pushes the pusher tip straight down from 36 mm above the button
    to 8 mm into it and back up; 36 mm keeps the second arm inside +45 with the
    70 mm pusher. PRESS_CLOSE_AT 0.75 for the 44 mm push; Morse decodes for
    switch depths 0.5 to 7 mm. Same in test_combined, capture_points, the
    simulator and the docs.
    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
2026-10-25 Flip MAIN_DIR: the main arm leaned back instead of forward
    Set in arm_controller and the three test sketches that copy it.
    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
    [arm_controller.ino, capture_points.ino, test_combined.ino, test_servos.ino]
2026-10-25 Calibration tools: zero points in test_servos, press tuning in capture_points
    test_servos: l+/l-/r+/r- nudge one main arm servo on its own, and c prints
    the four SERVO_ZERO lines for the current position. capture_points at E:
    tt test dash, d+/d- press depth, u+/u- wait height, printed with the
    paste lines.
    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
2026-10-25 Soft start, firmer presses, quicker gestures, wider A/B search, colour wave, level meter
    - Soft start: each servo creeps to rest in short pulse bursts (base last,
    slowest) instead of jumping, in arm_controller and the three test sketches.
    - Point E: presses at 120 deg/s, 200 ms ramps, 12 mm past contact; Morse
    decodes for switch depths 1 to 11 mm.
    - Gestures 20% quicker (36 deg/s, 720 ms steps, 320 ms pauses).
    - A and B: window 2 to 25 cm, and a small look left/right/up/down when
    nothing is straight ahead.
    - C: the sensor waves over five spots and keeps the clearest reading.
    - D: the indicator move rises from the bottom of the scale like a level
    meter, twice, then holds.
    Co-Authored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
    [arm_controller.ino, capture_points.ino, test_combined.ino, test_servos.ino]
2026-10-26 Report, CAD (STEP) and FEA deliverables; demo notes for the soft start
    report/: Word and PDF report with build script and figures.
    hardware/cad/arm/: parametric CadQuery model, STEP per part and two
    assemblies (rest pose, Point B), renders.
    hardware/fea/: 3D brick-element FEA of both links, verified against beam
    theory, with results and stress plots.
    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
    [assembly_point_B.step, assembly_rest_pose.step, base_plate.step, bracket.step, hub.step, main_arm.step, pusher.step, second_arm.step]
2026-10-26 Point E: higher travel pose, receivers centred on measured press timing
    Raise the travel elbow to 30 so the pusher stays about 57 mm above the
    button while the base swings. Receivers now split dot/dash at 1250 ms,
    end letters at 1200 ms and merge contact bounce under 100 ms; checked
    against the arm's simulated contact timeline with chatter and jitter.
    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
    [arm_controller.ino, build_report.py, capture_points.ino, morse_receiver.ino, morse_receiver_i2c.ino, test_combined.ino]
2026-10-26 Bigger press stroke, main arm lean at the press, base sweep and speed cap, fine search sketch
    Point E: hover 38 mm, push 20 mm past contact (58 mm stroke), main arm
    leans 3 deg extra at the bottom so its servos push too. Button now works
    from 30 mm high to 32 mm low; receivers recheck clean, comments updated.
    Start up: head up, slow base sweep to both ends and back to the middle.
    Base capped at 18 deg/s (24 in gestures). More ultrasonic and colour
    samples, longer settle in scans. New arm_controller_fine sketch with a
    small hill climb search at A, B and C.
    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
2026-10-26 Free flash so both arm sketches fit the Uno
    Drop the colour temperature and lux printout and the unused second arm
    limit fallback at Point E (the 38 mm hover keeps the second arm at
    44.4 deg), and shorten a few long Serial messages.
    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
    [arm_controller.ino, arm_controller_fine.ino]
2026-10-26 Fine search reuses the ultrasonic reading; fine sketch skips the sensor positions line
    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
    [arm_controller.ino, arm_controller_fine.ino]
2026-10-26 Correct the press tolerance comment
    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
    [arm_controller.ino, arm_controller_fine.ino]
2026-10-26 Add an ultrasonic fault finder sketch
    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
2026-10-26 Bigger gestures, 70 mm press travel, base-only test sketch
    Gestures are now set as joint angles so they are always full size: YES
    nods the second arm 20 deg each way, NO and BOX swing the base 25 deg
    each way, BOX rises 40 deg above B. The pusher waits 70 mm above the
    button (second arm limit raised to +60), a 90 mm stroke. PRESS_CLOSE_AT
    0.6 centres the timing: the button sees 600/1800/590/1790 ms at the
    expected height and decodes from 50 mm high to 32 mm low. Receiver
    thresholds unchanged, comments updated. New tests/test_base for fitting
    the turntable at the servo's middle and setting SERVO_ZERO_BASE.
    Claude-Session: https://claude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
2026-10-26 Add a base servo left/right range test
    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
2026-10-26 Base calibration for the SG92R: BASE_GAIN and its full pulse range
    The base can now use 500 to 2500 us (the Servo library limits it to 544
    to 2400 unless told otherwise) and BASE_GAIN corrects a base that turns
    less than commanded. tests/test_base works out BASE_GAIN with the new k
    command; test_base_range now really reaches 500 and 2500 us. All arm
    sketches share the same base pulse code.
    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
    [arm_controller.ino, arm_controller_fine.ino, capture_points.ino, test_base.ino, test_base_range.ino, test_combined.ino, test_servos.ino]
2026-10-26 Earlier arm_controller version with a built-in colour sensor driver
    The team's last working sketch failed to compile on a laptop without the
    Adafruit TCS34725 library. It now talks to the sensor over Wire directly
    (same 50 ms / 4x settings and same raw readings), so nothing needs
    installing. Everything else is unchanged.
    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
    [arm_controller_v1.ino]
2026-10-26 Start the run straight after the 5 s rest hold
    The soft start now runs inside the 5 s hold (8/8/14 bursts, about 4 s),
    the 30 s base sweep is off by default and the start-up LED and beep check
    is removed. Task beeps stay, with TASK_BEEPS to switch them off.
    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
2026-10-26 Built-in colour sensor driver in arm_controller, no library folder needed
    The sketch now works when pasted into a fresh Arduino sketch: the
    TCS34725 is read over Wire directly (50 ms, 4x gain, same raw values),
    so the bundled src/ library is removed from arm_controller and
    arm_controller_fine.
    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
2026-10-26 Bring back the start-up LED and beeper check, inside the 5 s hold
    Red, green and blue light in turn with a beep each while the servos creep
    to rest, so every function is still there and the run still starts 5 s
    after reset.
    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
    [arm_controller.ino, arm_controller_fine.ino]
2026-10-26 Colour sensor start-up can no longer freeze the arm
    A stuck I2C bus on A4/A5 made Wire wait forever inside tcs.begin(), so the
    run never started. Wire now gives up after 25 ms and the run carries on
    with the colour sensor marked missing. Same fix in arm_controller_v1.
    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
    [arm_controller.ino, arm_controller_fine.ino, arm_controller_v1.ino]
2026-10-26 No checks at power up: the demo just starts
    START_CHECKS (off) skips the LED and beeper test, and the colour sensor
    is started when the arm reaches Point C instead of at power up, so
    nothing can hold up the start of the run.
    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
    [arm_controller.ino, arm_controller_fine.ino]
2026-10-26 Base turns 20% further (BASE_GAIN 1.2)
    The base stopped short of A and B. Every base move is now scaled by 1.2,
    and the base pulse limits are 450 to 2550 us so the extra travel is not
    cut off (A/B at 2462 us, E at 482 us). Test sketches use the same values.
    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
    [arm_controller.ino, arm_controller_fine.ino, capture_points.ino, test_combined.ino, test_servos.ino]
